ohjaeyoung0519/edge-iot-control-system/images/results/light_switch_node_servo_mount.jpeg

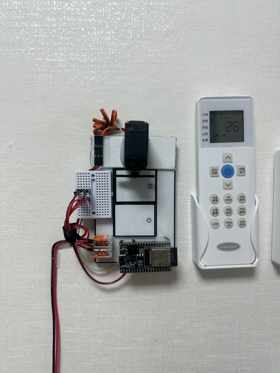
images/results/light_switch_node_servo_mount.jpeg
