ohjaeyoung0519/edge-iot-control-system/docs/hardware_list.md

# Hardware List

> 이 목록은 개발 당시 준비·계획한 하드웨어 기록입니다. IR 및 Camera/Vision 관련 항목은 **최종 구현 범위에 포함되지 않습니다.** 최종 구현은 Light Switch Node와 PC Power Node이며, 현재 구성은 [프로젝트 README](../README.md)를 기준으로 합니다.

| Component | Quantity | Purpose | Status |
|---|---:|---|---|
| Raspberry Pi 5 8GB | 1 | Central edge server | Received |
| Raspberry Pi USB-C Power Adapter | 1 | Raspberry Pi power supply | Received |
| Raspberry Pi Active Cooler / Case | 1 | Raspberry Pi cooling and protection | Received |
| microSD Card 64GB | 1 | Raspberry Pi OS storage | Received |
| microSD Reader | 1 | Raspberry Pi OS flashing | Received |
| LAN Cable | 1 | Initial Raspberry Pi network setup | Received |
| Micro HDMI Cable | 1 | Display connection during initial setup | Received |
| ESP32-DEVKITC-32E | 3 | Wireless hardware control nodes | Received |
| SG90 Servo Motor | 1 | Lightweight physical switch control and servo test | Received |
| MG90S Servo Motor | 1 | Higher torque servo motor test and physical switch control | Received |
| 5V 5A DC Adapter | 1 | External power supply for servo motors | Received |
| DC Jack Terminal | 1 | External 5V power input connection | Received |
| WAGO Connectors | 1 set | 5V and GND power distribution | Received |
| Red Power Wire | 1 roll | 5V power wiring | Received |
| Black Power Wire | 1 roll | GND wiring | Received |
| Wire Stripper | 1 | Power wire cutting and stripping | Received |
| Breadboard | 4 | Circuit prototyping and temporary wiring | Received |
| Jumper Wires | 1 set | ESP32, sensor, and servo wiring | Received |
| Tact Switch | 5 | Local button input | Received |
| LDR Sensor Module | 1 | Analog light sensing and device state checking | Received |
| IR Receiver Module 38kHz | 2 | IR signal receiving | Received |
| IR LED 940nm | 5 | IR signal transmission | Received |
| 2N2222A NPN Transistor | 10 | IR LED driving circuit | Received |
| Resistor Kit | 1 set | Current limiting and signal circuit construction | Received |
| 1000uF 25V Capacitor | 5 | Servo power stabilization | Received |
| Digital Multimeter | 1 | Voltage and continuity measurement | Received |
| Infrared Thermometer | 1 | Servo motor surface temperature measurement | Received |
| Electrical Tape | 1 | Insulation and temporary sensor fixing | Received |
| Masking Tape | 1 | Temporary labeling and safe attachment | Received |
| Cable Ties | 1 set | Cable organization | Received |
| Velcro Cable Ties | 1 set | Reusable cable organization | Received |
| Double-sided Gel Tape | 1 | Temporary component fixing | Received |
| Raspberry Pi Camera Module | 1 | Future camera-based state recognition | Planned |
