ohjaeyoung0519/edge-iot-control-system/report/README.md

# Project Report / 프로젝트 보고서

**[대표 프로젝트 보고서 / Main Project Report (PDF)](Raspberry_Pi_5_ESP32_Edge_Control_System_Report.pdf)**

이 문서는 프로젝트의 대표 보고서입니다. 시스템 구현 배경, 실제 하드웨어 제어 과정, 성능 측정 설계, 주요 결과와 해석을 16페이지로 정리했습니다.

더 자세한 개발 과정과 실험 기록은 [Development & Experiment Documents](../docs/README.md)에서 확인할 수 있습니다. 기존 장문 보고서는 `docs/experiment-log/`에 개발·실험 기록으로 보존했습니다.

핵심 결과와 재현 정보는 [프로젝트 개요](../README.md)와 [실험 데이터 안내](../data/README.md)에서도 확인할 수 있습니다.

This is the main project report, summarizing the implementation, physical-control issues, benchmark design, key measurements, and interpretation in a 16-page document.

For the detailed development and experiment history, see [Development & Experiment Documents](../docs/README.md). The previous long-form report is preserved under `docs/experiment-log/` as a development and experiment log.

For key findings and reproducibility information, see the [project overview](../README_EN.md) and [dataset guide](../data/README_EN.md).
