ohjaeyoung0519/edge-iot-control-system/(commit log)

2026-09-18 docs: finalize repository organization and runtime fixes
    [light_switch_node.ino]
2026-09-18 chore: remove stale placeholders and duplicate legacy data
    [esp32_latency_rpi_to_esp32_100.csv]
2026-09-30 Clarify staged servo and mounting improvement sequence
